dkay64/HOPEDeCal/HeliCALFiles/DFM analysis report_JLCDFM_Drill Files.pdf

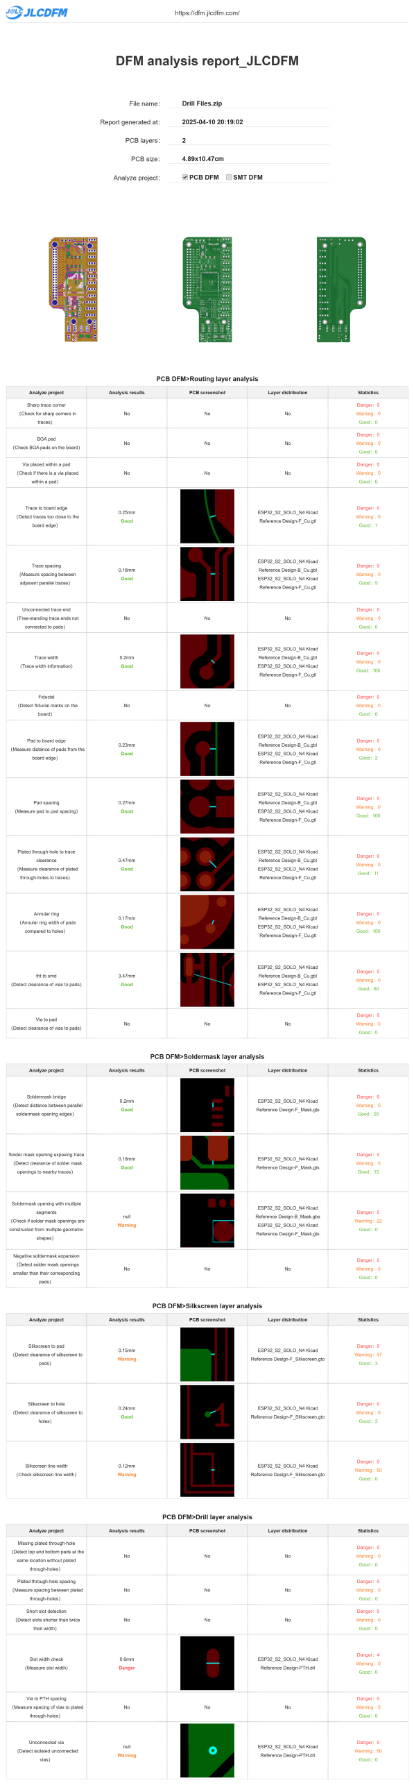
[picture p1: page 1]
