dkay64/HOPEDeCal/HeliCALFiles/HOPE HeliCAL Final Project BOM.xlsx

Sheet: BOM Template
Instructions
Fill in the cells with the YELLOW highlight. Do not edit red cells. WE WILL ADJUST THE MULTIPLIER TO ACCOUNT FOR MULTIPLE BOARDS, YOU SHOULD NOT. Fill out the Digi-Key part # OR the Mouser Part #, DO NOT fill out both. Choose the cheapest distributor that has the part in stock. If the part is not in stock by the time we order parts, there is a risk that we will not purchase it. For any approved Amazon or Adafruit parts, leave Digi-key and Mouser Part# columns blank like the example. For approved Amazon parts, put the ASIN (under the Product Information Section) for Manufacturer Part # in the format "Amazon - ##########". For approved Adafruit parts, put the Product ID for Manufacturer Part # in the format "Adafruit - ####". |  |  |  |  |  |  |  |  |  | Total Price for Project
 |  |  |  |  |  |  |  |  |  | $34.53
Qty (for 1 board) | Manufacturer Part # | Digi-key Part#/SKU | Price/unit ($) | Purchase URL | Reference Designator | Description (include component value if applicable) | Datasheet Link | Multiple | Total Qty | Total Price/part ($)
12 | 08056D104KAT2A | 478-08056D104KAT2ACT-ND | $0.10 | https://www.digikey.com/en/products/detail/kyocera-avx/08056D104KAT2A/11568656 | C1, C3, C5, C6, C7, C9 | CAP CER 0.1UF 6.3V X5R 0805 | http://datasheets.kyocera-avx.com/cx5r.pdf | 1 | 12 | $1.20
2 | CL10A106KQ8NNNC | 1276-1038-1-ND | $0.08 | https://www.digikey.com/en/products/detail/samsung-electro-mechanics/CL10A106KQ8NNNC/3886696 | C2 | CAP CER 10UF 6.3V X5R 0603 | https://mm.digikey.com/Volume0/opasdata/d220001/medias/docus/609/CL10A106KQ8NNNC_Spec.pdf | 1 | 2 | $0.16
2 | C0805C105K9RACTU | 399-13161-1-ND | $0.13 | https://www.digikey.com/en/products/detail/kemet/C0805C105K9RACTU/2211772 | C4 | CAP CER 1UF 6.3V X7R 0805 | https://search.kemet.com/download/datasheet/C0805C105K9RAC7800 | 1 | 2 | $0.26
2 | CHV1206N500103JCT | 4713-CHV1206N500103JCT-ND | $0.50 | https://www.digikey.com/en/products/detail/cal-chip-electronics-inc/CHV1206N500103JCT/22155331 | C8 | 0.01 µF ±5% 500V Ceramic Capacitor C0G, NP0 1206 (3216 Metric) | https://88ce57.p3cdn1.secureserver.net/wp-content/uploads/2023/01/chv_series-1.pdf | 1 | 2 | $1.00
2 | SML-D12D8WT86C | SML-D12D8WT86CCT-ND | $0.24 | https://www.digikey.com/en/products/detail/rohm-semiconductor/SML-D12D8WT86C/9448211 | D1 | LED ORANGE CLEAR 1608 SMD | https://fscdn.rohm.com/en/products/databook/datasheet/opto/led/chip_mono/sml-d12d8wt86(c)-e.pdf | 1 | 2 | $0.48
3 | SL84-3G | 4878-SL84-3GCT-ND | $0.53 | https://www.digikey.com/en/products/detail/diotec-semiconductor/SL84-3G/22189950 | D2, D3 | DIODE SCHOTTKY 40V 8A DO214AB | https://diotec.com/request/datasheet/sl82-3g.pdf | 1 | 3 | $1.59
5 | B4B-XH-A | 455-B4B-XH-A-ND | $0.17 | https://www.digikey.com/en/products/detail/jst-sales-america-inc/B4B-XH-A/1651047 | J14, J15, J16, J19 | CONN HEADER VERT 4POS 2.5MM | https://www.jst-mfg.com/product/pdf/eng/eXH.pdf | 1 | 5 | $0.85
3 | B2B-XH-A | 455-B2B-XH-A-ND | $0.10 | https://www.digikey.com/en/products/detail/jst-sales-america-inc/B2B-XH-A/1651045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 | J4, J17 | CONN HEADER VERT 2POS 2.5MM | https://www.jst-mfg.com/product/pdf/eng/eXH.pdf | 1 | 3 | $0.30
1 | USB4125-GF-A | 2073-USB4125-GF-ACT-ND | $0.59 | https://www.digikey.com/en/products/detail/gct/USB4125-GF-A/13547388 | J5 | CONN RCPT TYPE C 6P SMD RA | https://mm.digikey.com/Volume0/opasdata/d220001/medias/docus/6501/USB4125%20Product%20Spec.pdf | 1 | 1 | $0.59
10 | B3B-XH-A | 455-2248-ND | $0.13 | https://www.digikey.com/en/products/detail/jst-sales-america-inc/B3B-XH-A/1651046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 | J6, J7, J8, J9, J10, J11, J12, J13, J18 | CONN HEADER VERT 3POS 2.5MM | https://www.jst-mfg.com/product/pdf/eng/eXH.pdf | 1 | 10 | $1.30
4 | RC0603FR-075K1L | 311-5.10KHRCT-ND | $0.10 | https://www.digikey.com/en/products/detail/yageo/RC0603FR-075K1L/727268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 | R1, R3 | RES 5.1K OHM 1% 1/10W 0603 | https://www.yageo.com/upload/media/product/products/datasheet/rchip/PYu-RC_Group_51_RoHS_L_12.pdf | 1 | 4 | $0.40
2 | RT0603BRD07500RL | 13-RT0603BRD07500RLCT-ND | $0.10 | https://www.digikey.com/en/products/detail/yageo/RT0603BRD07500RL/17019950 | R2 | RES 500 OHM 0.1% 1/10W 0603 | https://www.yageo.com/upload/media/product/app/datasheet/rchip/pyu-rt_1-to-0.01_rohs_l.pdf | 1 | 2 | $0.20
8 | RR1220P-103-D | RR12P10.0KDCT-ND | $0.10 | https://www.digikey.com/en/products/detail/susumu/RR1220P-103-D/432315 | R4, R5, R6, R8 | RES SMD 10K OHM 0.5% 1/10W 0805 | https://www.susumu.co.jp/common/pdf/n_catalog_partition05_en.pdf | 1 | 8 | $0.80
1 | CF-LD-1DC-AR2W | 563-1943-ND | $3.31 | https://www.digikey.com/en/products/detail/nidec-components-corporation/CF-LD-1DC-AR2W/6008982 | SW1 | Rocker Switch SPDT 0.4VA (AC/DC) 28 V Through Hole | https://www.nidec-copal-electronics.com/e/catalog/switch/cf-ld.pdf | 1 | 1 | $3.31
2 | FSM6JSMA | 450-1133-ND | $0.28 | https://www.digikey.com/en/products/detail/te-connectivity-alcoswitch-switches/FSM6JSMA/525822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 | SW2, SW3 | SWITCH TACTILE SPST-NO 0.05A 24V | https://www.te.com/commerce/DocumentDelivery/DDEController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 | 1 | 2 | $0.56
1 | LD1117S33TR | 497-1242-1-ND | $0.34 | https://www.digikey.com/en/products/detail/stmicroelectronics/LD1117S33TR/585766 | U1 | IC REG LINEAR 3.3V 800MA SOT-223 | https://www.st.com/content/ccc/resource/technical/document/datasheet/99/3b/7d/91/91/51/4b/be/CD00000544.pdf/files/CD00000544.pdf/jcr:content/translations/en.C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 | 1 | 1 | $0.34
1 | M20-6102045 | M20-6102045 | $5.47 | https://www.digikey.com/en/products/detail/harwin-inc/M20-6102045/3728184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 | U2 | 40 Connector Stackthrough, Unkeyed (PC/104) Through Hole Black PC/104 | https://cdn.harwin.com/pdfs/M20-610.pdf | 1 | 1 | $5.47
1 | ESP32-S2-SOLO-2-N4 | 1965-ESP32-S2-SOLO-2-N4CT-ND | $4.25 | https://www.digikey.com/en/products/detail/espressif-systems/ESP32-S2-SOLO-2-N4/16591892 | U3 | RF TXRX MOD WIFI PCB TRACE SMD | https://www.espressif.com/sites/default/files/documentation/esp32-s2-solo-2_esp32-s2-solo-2u_datasheet_en.pdf | 1 | 1 | $4.25
1 | MPU-6500 | 1428-1011-1-ND | $7.17 | https://www.digikey.com/en/products/detail/tdk-invensense/MPU-6500/4385412 | U4 | IMU ACCEL/GYRO 3-AXIS I2C 24QFN | https://invensense.tdk.com/wp-content/uploads/2020/06/PS-MPU-6500A-01-v1.3.pdf | 1 | 1 | $7.17
5 | 3220-10-0100-00 | 1175-1627-ND | $0.56 | https://www.digikey.com/en/products/detail/cnc-tech/3220-10-0100-00/3883661 | U6, U7, U8, U9 | Connector Header Through Hole 10 position 0.050" (1.27mm) | http://www.cnctech.us/pdfs/3220-XX-0100-00_.pdf | 1 | 5 | $2.80
2 | XHP-2 | 455-2266-ND | $0.10 | https://www.digikey.com/en/products/detail/jst-sales-america-inc/XHP-2/555485 |  | CONN RCPT HSG 2POS 2.50MM | https://www.jst-mfg.com/product/pdf/eng/eXH.pdf | 1 | 2 | $0.20
9 | XHP-3 | 455-2219-ND | $0.10 | https://www.digikey.com/en/products/detail/jst-sales-america-inc/XHP-3/1651017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 |  | CONN RCPT HSG 3POS 2.50MM | https://www.jst-mfg.com/product/pdf/eng/eXH.pdf | 1 | 9 | $0.90
4 | XHP-4 | 455-2267-ND | $0.10 | https://www.digikey.com/en/products/detail/jst-sales-america-inc/XHP-4/683353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 |  | CONN RCPT HSG 4POS 2.50MM | https://www.jst-mfg.com/product/pdf/eng/eXH.pdf | 1 | 4 | $0.40
 |  |  |  |  |  |  |  |  | 0 | 0
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
 |  |  |  |  |  |  |  |  | 0 | 0
 |  |  |  |  |  |  |  |  | 0 | 0
 |  |  |  |  |  |  |  |  | 0 | 0
 |  |  |  |  |  |  |  |  | 0 | 0
 |  |  |  |  |  |  |  |  | 0 | 0
 |  |  |  |  |  |  |  |  | 0 | 0
 |  |  |  |  |  |  |  |  | 0 | 0
 |  |  |  |  |  |  |  |  | 0 | 0
 |  |  |  |  |  |  |  |  | 0 | 0
 |  |  |  |  |  |  |  |  | 0 | 0
 |  |  |  |  |  |  |  |  | 0 | 0
 |  |  |  |  |  |  |  |  | 0 | 0
 |  |  |  |  |  |  |  |  | 0 | 0
 |  |  |  |  |  |  |  |  | 0 | 0
 |  |  |  |  |  |  |  |  | 0 | 0
 |  |  |  |  |  |  |  |  | 0 | 0
 |  |  |  |  |  |  |  |  | 0 | 0
 |  |  |  |  |  |  |  |  | 0 | 0
 |  |  |  |  |  |  |  |  | 0 | 0
 |  |  |  |  |  |  |  |  | 0 | 0
 |  |  |  |  |  |  |  |  | 0 | 0
 |  |  |  |  |  |  |  |  | 0 | 0
 |  |  |  |  |  |  |  |  | 0 | 0
 |  |  |  |  |  |  |  |  | 0 | 0
 |  |  |  |  |  |  |  |  | 0 | 0
 |  |  |  |  |  |  |  |  | 0 | 0
 |  |  |  |  |  |  |  |  | 0 | 0
 |  |  |  |  |  |  |  |  | 0 | 0
 |  |  |  |  |  |  |  |  | 0 | 0
 |  |  |  |  |  |  |  |  | 0 | 0
 |  |  |  |  |  |  |  |  | 0 | 0
 |  |  |  |  |  |  |  |  | 0 | 0
 |  |  |  |  |  |  |  |  | 0 | 0
 |  |  |  |  |  |  |  |  | 0 | 0

Sheet: Example BOM
Partner 1 Name: John James | Partner 1 Email: realemail@berkeley.edu | Partner 2 Name: Erin Edison | Partner 2 Email: fakeemail@berkeley.edu | Partner 3 Name: Jim Mulligan | Partner 3 Email: superemail@berkeley.edu
Instructions
Fill in the cells with the YELLOW highlight. Do not edit red cells. WE WILL ADJUST THE MULTIPLIER TO ACCOUNT FOR MULTIPLE BOARDS, YOU SHOULD NOT. Fill out the Digi-Key part # OR the Mouser Part #, DO NOT fill out both. Choose the cheapest distributor that has the part in stock. If the part is not in stock by the time we order parts, there is a risk that we will not purchase it. For any approved Amazon or Adafruit parts, leave Digi-key and Mouser Part# columns blank like the example. For approved Amazon parts, put the ASIN (under the Product Information Section) for Manufacturer Part # in the format "Amazon - ##########". For approved Adafruit parts, put the Product ID for Manufacturer Part # in the format "Adafruit - ####" |  |  |  |  |  |  |  |  |  |  | Total Price for Project
 |  |  |  |  |  |  |  |  |  |  | $102.44
Qty (for 1 board) | Manufacturer Part # | Digi-key Part#/SKU | Mouser Part#/SKU | Price/unit ($) | Purchase URL | Reference Designator | Description (include component value if applicable) | Datasheet Link | Multiple | Total Qty | Total Price/part ($)
1 | ESP32-S2-SOLO-N4 | 1965-ESP32-S2-SOLO-N4CT-ND |  | $2.32 | ESP32-S2-SOLO-N4 Espressif Systems | RF/IF and RFID | DigiKey (https://www.digikey.com/en/products/detail/espressif-systems/esp32-s2-solo-n4/15222511) | U1 | WiFi 802.11b/g/n Transceiver Module 2.4GHz PCB Trace + IPEX Surface Mount | https://www.espressif.com/sites/default/files/documentation/esp32-s2-solo_esp32-s2-solo-u_datasheet_en.pdf | 2 | 2 | $4.64
1 | COM-18085 | 1568-COM-18085CT-ND |  | $9.75 | COM-18085 SparkFun Electronics | RF/IF and RFID | DigiKey (https://www.digikey.com/en/products/detail/sparkfun-electronics/COM-18085/16344552) | U2 | General ISM < 1GHz LoRa Transceiver Module 137MHz ~ 1.02GHz Antenna Not Included Surface Mount | https://cdn.sparkfun.com/assets/1/5/d/6/6/RFM95CW_Specification_EN_V1.0.pdf | 2 | 2 | $19.50
1 | PAM8302AASCR |  | 621-PAM8302AASCR | $0.44 | PAM8302AASCR Diodes Incorporated | Mouser (https://www.mouser.com/ProductDetail/Diodes-Incorporated/PAM8302AASCR?qs=pYVYkI7xuRXTVZEQSGcDyg%3D%3D) | U3 | Amplifier IC 1-Channel (Mono) Class D 8-MSOP | https://www.diodes.com/assets/Datasheets/PAM8302A.pdf https://www.diodes.com/assets/Evaluation-Boards/PAM8302A-User-Guide.pdf https://support.envistiamall.com/wp-content/uploads/2021/05/PAM8302A-module-schematic-Cropped.jpg | 2 | 2 | $0.88
1 | AS04004CO-2-R | 668-AS04004CO-2-R-ND |  | $2.67 | AS04004CO-2-R PUI Audio, Inc. | Audio Products | DigiKey (https://www.digikey.com/en/products/detail/pui-audio-inc/AS04004CO-2-R/11618422) | LS1 | SPEAKER 1.5W 4 OHM 550 HZ 84DB | http://puiaudio.com/pdf/AS04004CO-2-R.PDF | 2 | 2 | $5.34
1 | ANT-916-PW-RA | ANT-916-PW-RA-ND |  | $4.17 | ANT-916-PW-RA Linx Technologies Inc. | RF/IF and RFID | DigiKey (https://www.digikey.com/en/products/detail/linx-technologies-inc/ANT-916-PW-RA/340124) | AE1 | 915MHz ISM, LoRa, Sensor Networks, SigFox Whip, Tilt RF Antenna 816MHz ~ 1.095GHz 0dBi Screw-Mount Panel Mount | https://linxtechnologies.com/wp/wp-content/uploads/ant-916-pw-ra.pdf | 2 | 2 | $8.34
1 | MFS201N-9-Z | 563-1565-ND |  | $0.43 | 1825232-1 TE Connectivity ALCOSWITCH Switches | Switches | DigiKey (https://www.digikey.com/en/products/detail/te-connectivity-alcoswitch-switches/1825232-1/4021554) | S1 | Slide Switch SPDT Through Hole | https://www.te.com/commerce/DocumentDelivery/DDEController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 | 2 | 2 | $0.86
1 | GF-123-0000 | CWI332-ND |  | $1.06 | GF-123-0000 CW Industries | Switches | DigiKey (https://www.digikey.com/en/products/detail/cw-industries/GF-123-0000/4089767) | S2 | Slide Switch SPST Panel Mount | http://switches-connectors-custom.cwind.com/Asset/GF-123-Dimension-DRAWING.pdf | 2 | 2 | $2.12
3 | RMCF0603FT10K0 | RMCF0603FT10K0CT-ND |  | $0.10 | RMCF0603FT10K0 Stackpole Electronics Inc | Resistors | DigiKey (https://www.digikey.com/en/products/detail/stackpole-electronics-inc/RMCF0603FT10K0/1761235) | R1, R5, R6 | 10 kOhms ±1% 0.1W, 1/10W Chip Resistor 0603 (1608 Metric) Automotive AEC-Q200 Thick Film | https://www.seielect.com/catalog/sei-rmcf_rmcp.pdf | 2 | 6 | $0.60
1 | RMCF0402ZT0R00 | RMCF0402ZT0R00CT-ND |  | $0.10 | RMCF0402ZT0R00 Stackpole Electronics Inc | Resistors | DigiKey (https://www.digikey.com/en/products/detail/stackpole-electronics-inc/RMCF0402ZT0R00/1756905) | R2 | 0 Ohms Jumper 0.063W, 1/16W Chip Resistor 0402 (1005 Metric) Automotive AEC-Q200 Thick Film | https://www.seielect.com/catalog/sei-rmcf_rmcp.pdf | 2 | 2 | $0.20
5 | 06035C104KAT2A | 478-5052-1-ND |  | $0.10 | 06035C104KAT2A KYOCERA AVX | Capacitors | DigiKey (https://www.digikey.com/en/products/detail/kyocera-avx/06035C104KAT2A/1600046) | C1, C12, C13, C15, C21 | 0.1 µF ±10% 50V Ceramic Capacitor X7R 0603 (1608 Metric) | https://datasheets.kyocera-avx.com/X7RDielectric.pdf | 2 | 10 | $1.00
1 | CC0402MRX5R6BB225 | 311-1733-1-ND |  | $0.10 | CC0402MRX5R6BB225 YAGEO | Capacitors | DigiKey (https://www.digikey.com/en/products/detail/yageo/CC0402MRX5R6BB225/5195142) | C2 | 2.2 µF ±20% 10V Ceramic Capacitor X5R 0402 (1005 Metric) | https://www.yageo.com/upload/media/product/productsearch/datasheet/mlcc/UPY-GPHC_X5R_4V-to-50V_26.pdf | 2 | 2 | $0.20
4 | C0402C220J3GACAUTO | 399-C0402C220J3GACAUTOCT-ND |  | $0.10 | C0402C220J3GACAUTO KEMET | Capacitors | DigiKey (https://www.digikey.com/en/products/detail/kemet/C0402C220J3GACAUTO/10642905) | C3, C4, C5, C6 | 22 pF ±5% 25V Ceramic Capacitor C0G, NP0 0402 (1005 Metric) | https://api.kemet.com/component-edge/download/datasheet/C0402C220J3GACAUTO.pdf | 2 | 8 | $0.80
1 | ATFC-0402HQ-1N8B-T | 535-12335-1-ND |  | $0.10 | ATFC-0402HQ-1N8B-T Abracon LLC | Inductors, Coils, Chokes | DigiKey (https://www.digikey.com/en/products/detail/abracon-llc/ATFC-0402HQ-1N8B-T/4215221) | L1 | 1.8 nH Unshielded Thin Film Inductor 650 mA 140mOhm Max 0402 (1005 Metric) | https://abracon.com/Magnetics/inductors/ATFC-0402HQ.pdf | 2 | 2 | $0.20
2 | 7447840147G | 732-7447840147GCT-ND |  | $0.10 | 7447840147G Würth Elektronik | Inductors, Coils, Chokes | DigiKey (https://www.digikey.com/en/products/detail/w%C3%BCrth-elektronik/7447840147G/14669548) | L2, L3 | 47 nH Unshielded Multilayer Inductor 200 mA 1.15Ohm Max 0402 (1005 Metric) | https://www.we-online.com/catalog/datasheet/7447840147G.pdf | 2 | 4 | $0.40
1 | LM2575D2T-3.3R4G |  | 863-LM2575D2T-3.3R4G | $2.38 | LM2575D2T-3.3R4G onsemi | Mouser (https://www.mouser.com/ProductDetail/onsemi/LM2575D2T-3.3R4G?qs=2OtswVQKCOFhf1pTPfoNzA%3D%3D) | U5 | Buck Switching Regulator IC Positive Fixed 3.3V 1 Output 1A TO-263-6, D²Pak (5 Leads + Tab), TO-263BA | https://www.onsemi.com/pdf/datasheet/lm2575-d.pdf | 2 | 2 | $4.76
1 | UUD1C270MCL1GS | 493-2257-1-ND |  | $0.48 | UUD1C270MCL1GS Nichicon | Capacitors | DigiKey (https://www.digikey.com/en/products/detail/nichicon/UUD1C270MCL1GS/589998) | C7 | 27 µF 16 V Aluminum Electrolytic Capacitors Radial, Can - SMD - 2000 Hrs @ 105°C | https://www.nichicon.co.jp/english/products/pdfs/e-uud.pdf | 2 | 2 | $0.96
1 | 865080142007 | 732-8472-1-ND |  | $0.20 | 865080142007 Würth Elektronik | Capacitors | DigiKey (https://www.digikey.com/en/products/detail/w%C3%BCrth-elektronik/865080142007/5728067) | C8 | 100 µF 6.3 V Aluminum Electrolytic Capacitors Radial, Can - SMD - 2000 Hrs @ 105°C | https://www.we-online.com/katalog/datasheet/865080142007.pdf | 2 | 2 | $0.40
1 | 1N5817 | 497-4547-1-ND |  | $0.42 | 1N5817 STMicroelectronics | Discrete Semiconductor Products | DigiKey (https://www.digikey.com/en/products/detail/stmicroelectronics/1N5817/770971) | D1 | Diode Schottky 20 V 1A Through Hole DO-41 | https://www.st.com/content/ccc/resource/technical/document/datasheet/26/db/14/60/52/47/47/5b/CD00001625.pdf/files/CD00001625.pdf/jcr:content/translations/en.C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 | 2 | 2 | $0.84
1 | AIUR-09-151K | AIUR-09-151K-ND |  | $0.83 | AIUR-09-151K Abracon LLC | Inductors, Coils, Chokes | DigiKey (https://www.digikey.com/en/products/detail/abracon-llc/AIUR-09-151K/2343697) | L4 | 150 µH Unshielded Wirewound Inductor 1 A 510mOhm Max Radial, Vertical Cylinder | https://abracon.com/Magnetics/radial/AIUR-09_Datasheet1.pdf | 2 | 2 | $1.66
5 | CL10B105MO8NNWC | 1276-6524-1-ND |  | $0.10 | CL10B105MO8NNWC Samsung Electro-Mechanics | Capacitors | DigiKey (https://www.digikey.com/en/products/detail/samsung-electro-mechanics/CL10B105MO8NNWC/5961008) | C9, C10, C11, C14, C16 | 1 µF ±20% 16V Ceramic Capacitor X7R 0603 (1608 Metric) | https://media.digikey.com/pdf/Data%20Sheets/Samsung%20PDFs/CL10B105MO8NNWC.pdf | 2 | 10 | $1.00
1 | 0ZRP0065FF1E | 507-2404-ND |  | $0.40 | 0ZRP0065FF1E Bel Fuse Inc. | Circuit Protection | DigiKey (https://www.digikey.com/en/products/detail/bel-fuse-inc/0ZRP0065FF1E/9468253) | F1 | Polymeric PTC Resettable Fuse 60V 650 mA Ih Through Hole Radial, Disc | https://media.digikey.com/pdf/Data%20Sheets/Bel%20Fuse%20PDFs/0ZRP_Series.pdf | 2 | 2 | $0.80
2 | GPTS203211B | CW181-ND |  | $1.71 | GPTS203211B CW Industries | Switches | DigiKey (https://www.digikey.com/en/products/detail/cw-industries/GPTS203211B/3190590) | S3, S4 | Pushbutton Switch SPST Standard Through Hole | http://switches-connectors-custom.cwind.com/Asset/GPTS203211BR2.pdf | 2 | 4 | $6.84
2 | 860020372001 | 732-8788-1-ND |  | $0.10 | 860020372001 Würth Elektronik | Capacitors | DigiKey (https://www.digikey.com/en/products/detail/w%C3%BCrth-elektronik/860020372001/5728733) | C17, C20 | 10 µF 16 V Aluminum Electrolytic Capacitors Radial, Can - 2000 Hrs @ 105°C | https://www.we-online.com/katalog/datasheet/860020372001.pdf | 2 | 4 | $0.40
2 | 0603B221K500CT | 1292-1407-1-ND |  | $0.10 | 0603B221K500CT Walsin Technology Corporation | Capacitors | DigiKey (https://www.digikey.com/en/products/detail/walsin-technology-corporation/0603B221K500CT/9354904) | C18, C19 | 220 pF ±10% 50V Ceramic Capacitor X7R 0603 (1608 Metric) | http://www.passivecomponent.com/wp-content/uploads/datasheet/WTC_MLCC_General_Purpose.pdf | 2 | 4 | $0.40
2 | MAF1608GAD601CT000 | 445-181518-1-ND |  | $0.21 | MAF1608GAD601CT000 TDK Corporation | Filters | DigiKey (https://www.digikey.com/en/products/detail/tdk-corporation/MAF1608GAD601CT000/9951529) | FB1, FB2 | 120 Ohms @ 100 MHz 1 Power Line Ferrite Bead 0603 (1608 Metric) 1A 150mOhm | https://product.tdk.com/en/system/files | 2 | 4 | $0.84
2 | RMCF0603FT100R | RMCF0603FT100RCT-ND |  | $0.10 | RMCF0603FT100R Stackpole Electronics Inc | Resistors | DigiKey (https://www.digikey.com/en/products/detail/stackpole-electronics-inc/RMCF0603FT100R/1761113) | R3, R4 | 100 Ohms ±1% 0.1W, 1/10W Chip Resistor 0603 (1608 Metric) Automotive AEC-Q200 Thick Film | https://www.seielect.com/catalog/sei-rmcf_rmcp.pdf | 2 | 4 | $0.40
1 | TC33X-1-103E | TC33X-1-103ECT-ND |  | $0.28 | TC33X-1-103E Bourns Inc. | Potentiometers, Variable Resistors | DigiKey (https://www.digikey.com/en/products/detail/bourns-inc/TC33X-1-103E/2566867) | RV1 | 10 kOhms 0.1W, 1/10W J Lead Surface Mount Trimmer Potentiometer Cermet 1.0 Turn Top Adjustment | https://www.bourns.com/docs/Product-Datasheets/TC33.pdf | 2 | 2 | $0.56
1 | 10118194-0001LF | 609-4618-1-ND |  | $0.48 | 10118194-0001LF Amphenol ICC (FCI) | Connectors, Interconnects | DigiKey (https://www.digikey.com/en/products/detail/amphenol-icc-fci/10118194-0001LF/2785389) | J1 | USB - micro B USB 2.0 Receptacle Connector 5 Position Surface Mount, Right Angle; Through Hole | https://www.amphenol-icc.com/media/wysiwyg/files/drawing/10118194.pdf | 2 | 2 | $0.96
2 | B1911NG--20D000214U1930 | 3147-B1911NG--20D000214U1930CT-ND |  | $0.10 | B1911NG--20D000214U1930 Harvatek Corporation | Optoelectronics | DigiKey (https://www.digikey.com/en/products/detail/harvatek-corporation/B1911NG-20D000214U1930/15519989) | D2, D3 | LED GREEN CLEAR 1608 SMD | https://media.digikey.com/pdf/Data%20Sheets/Harvatek%20PDFs/B1911NG--20D000214U1930.pdf | 2 | 4 | $0.40
1 | CRGCQ0603F120R | A129677CT-ND |  | $0.10 | CRGCQ0603F120R TE Connectivity Passive Product | Resistors | DigiKey (https://www.digikey.com/en/products/detail/te-connectivity-passive-product/CRGCQ0603F120R/8576279) | R7 | 120 Ohms ±1% 0.1W, 1/10W Chip Resistor 0603 (1608 Metric) Automotive AEC-Q200, Moisture Resistant Thick Film | https://www.te.com/commerce/DocumentDelivery/DDEController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 | 2 | 2 | $0.20
1 | Amazon - B09PN8S8L1 |  |  | $27.99 | Amazon.com: MUSIBEAUTY Universal 18650 Charger Battery with Rechargeable Battery 3.7V 3400mAh (4 Pack) for Doorbells, Flashlights, Headlamps, Cameras, Toys, and Remote Controls : Electronics (https://www.amazon.com/MUSIBEAUTY-Universal-Rechargeable-Doorbells-Flashlights/dp/B09PN8S8L1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) | B1, B2 | Universal 18650 Charger Battery with Rechargeable Battery 3.7V 3400mAh (4 Pack) |  | 1 | 1 | $27.99
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
 |  |  |  |  |  |  |  |  |  | 0 | 0
 |  |  |  |  |  |  |  |  |  | 0 | 0
 |  |  |  |  |  |  |  |  |  | 0 | 0
 |  |  |  |  |  |  |  |  |  | 0 | 0
 |  |  |  |  |  |  |  |  |  | 0 | 0
 |  |  |  |  |  |  |  |  |  | 0 | 0
 |  |  |  |  |  |  |  |  |  | 0 | 0
 |  |  |  |  |  |  |  |  |  | 0 | 0
 |  |  |  |  |  |  |  |  |  | 0 | 0
 |  |  |  |  |  |  |  |  |  | 0 | 0
 |  |  |  |  |  |  |  |  |  | 0 | 0
 |  |  |  |  |  |  |  |  |  | 0 | 0
 |  |  |  |  |  |  |  |  |  | 0 | 0
 |  |  |  |  |  |  |  |  |  | 0 | 0
 |  |  |  |  |  |  |  |  |  | 0 | 0
 |  |  |  |  |  |  |  |  |  | 0 | 0
