dkay64/HOPEDeCal/HeliCALFiles/Project/ESP32_S2_SOLO_N4 Kicad Reference Design.pdf

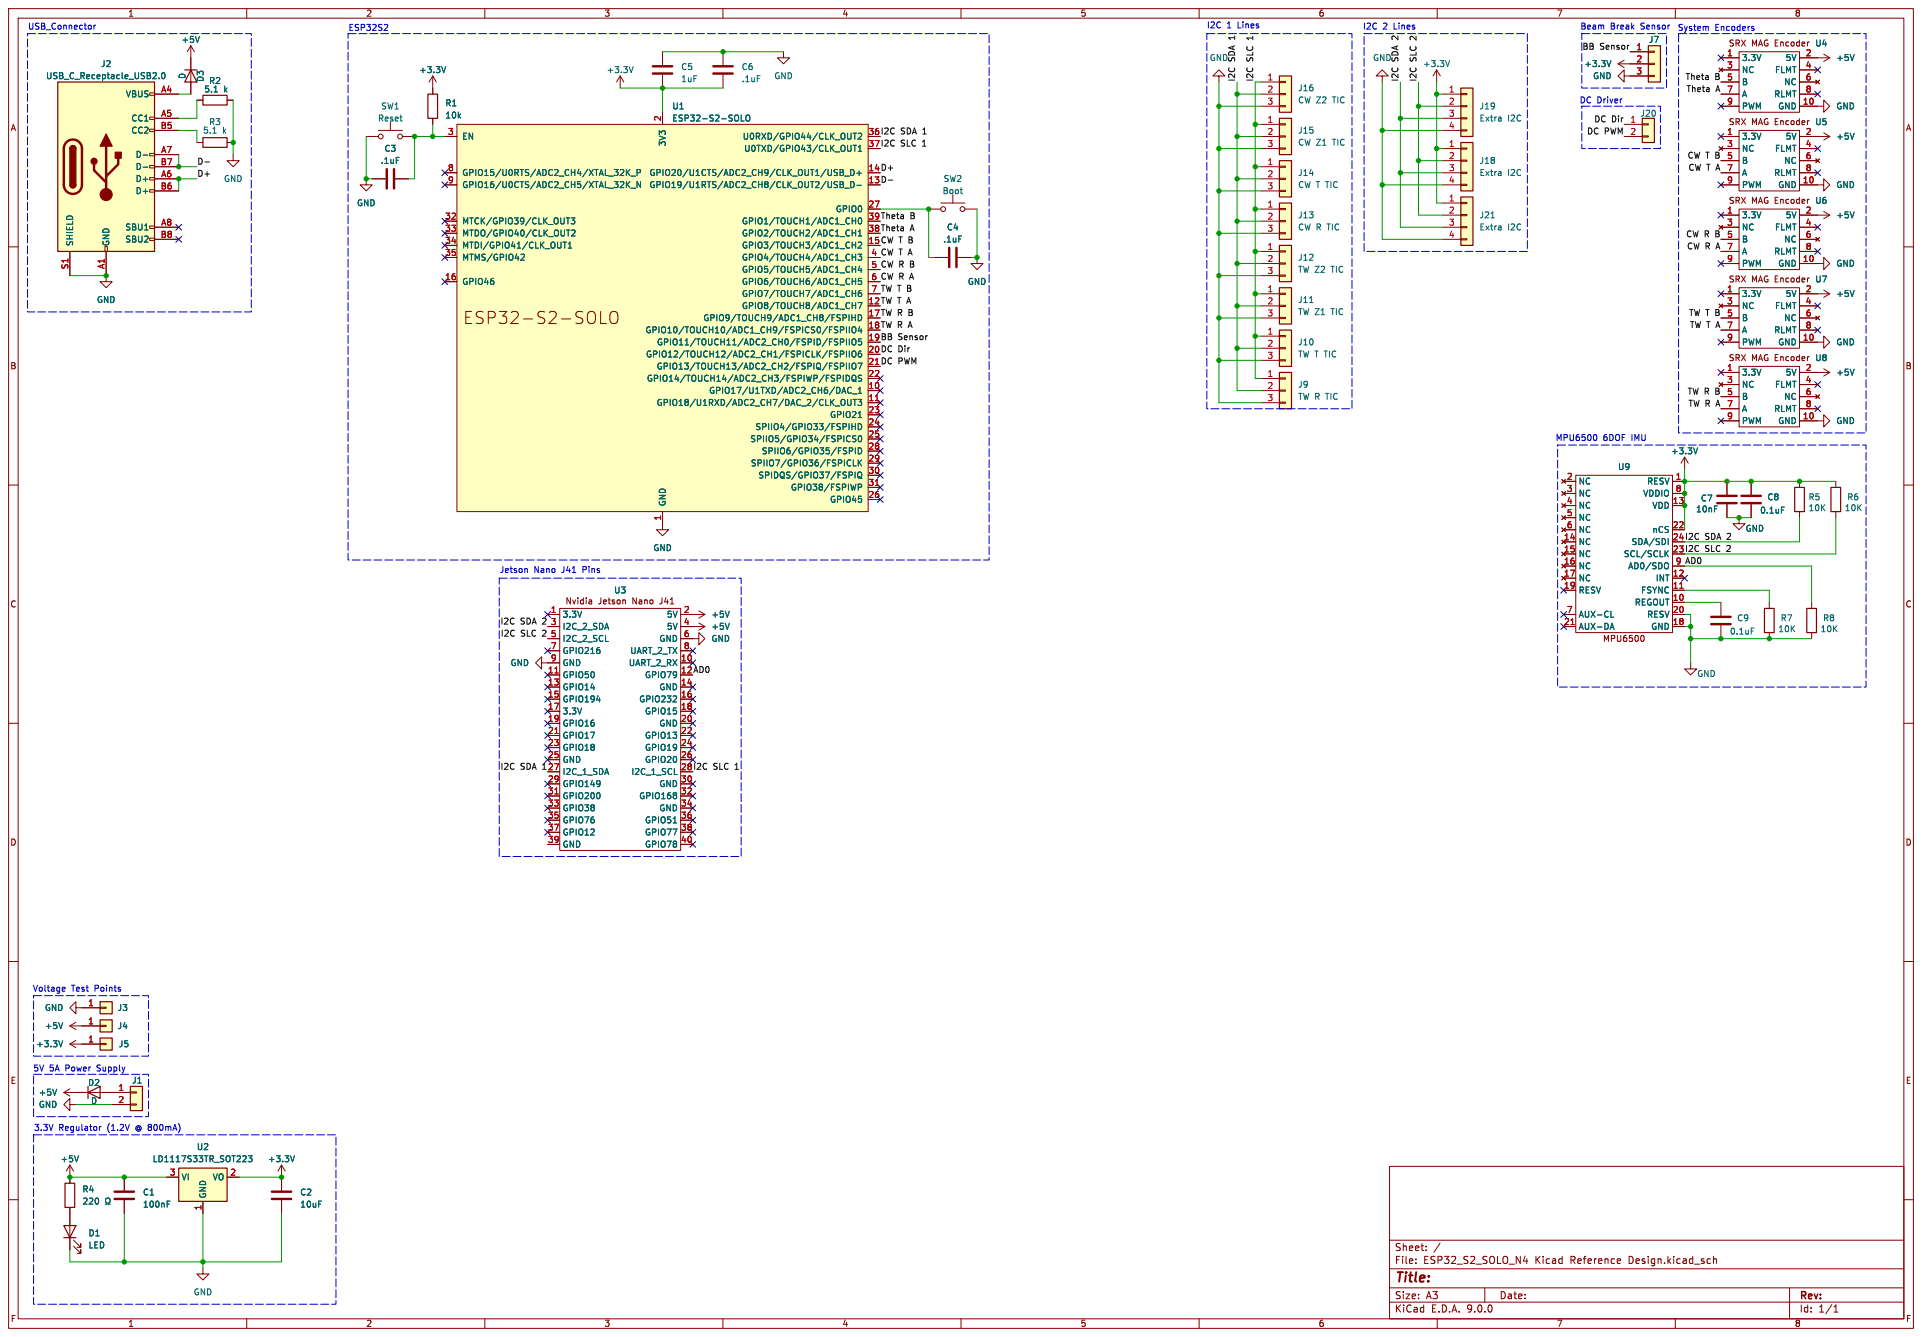
[picture p2: page 1]

DC Dir DC PWM

SRX MAG Encoder 3.3V 1 NC 3 B 5 A 7 PWM 9
3.3V 1 NC 3 B 5 A 7 PWM 9

5V 2 FLMT 4 NC 6 RLMT 8 GND
