dkay64/HOPEDeCal/HeliCALFiles/Project/ESP32_S2_SOLO_N4 Kicad Reference Design.kicad_pcb

## KiCad design HeliCALFiles/Project/ESP32_S2_SOLO_N4 Kicad Reference Design.kicad_pcb (2025-05-08)

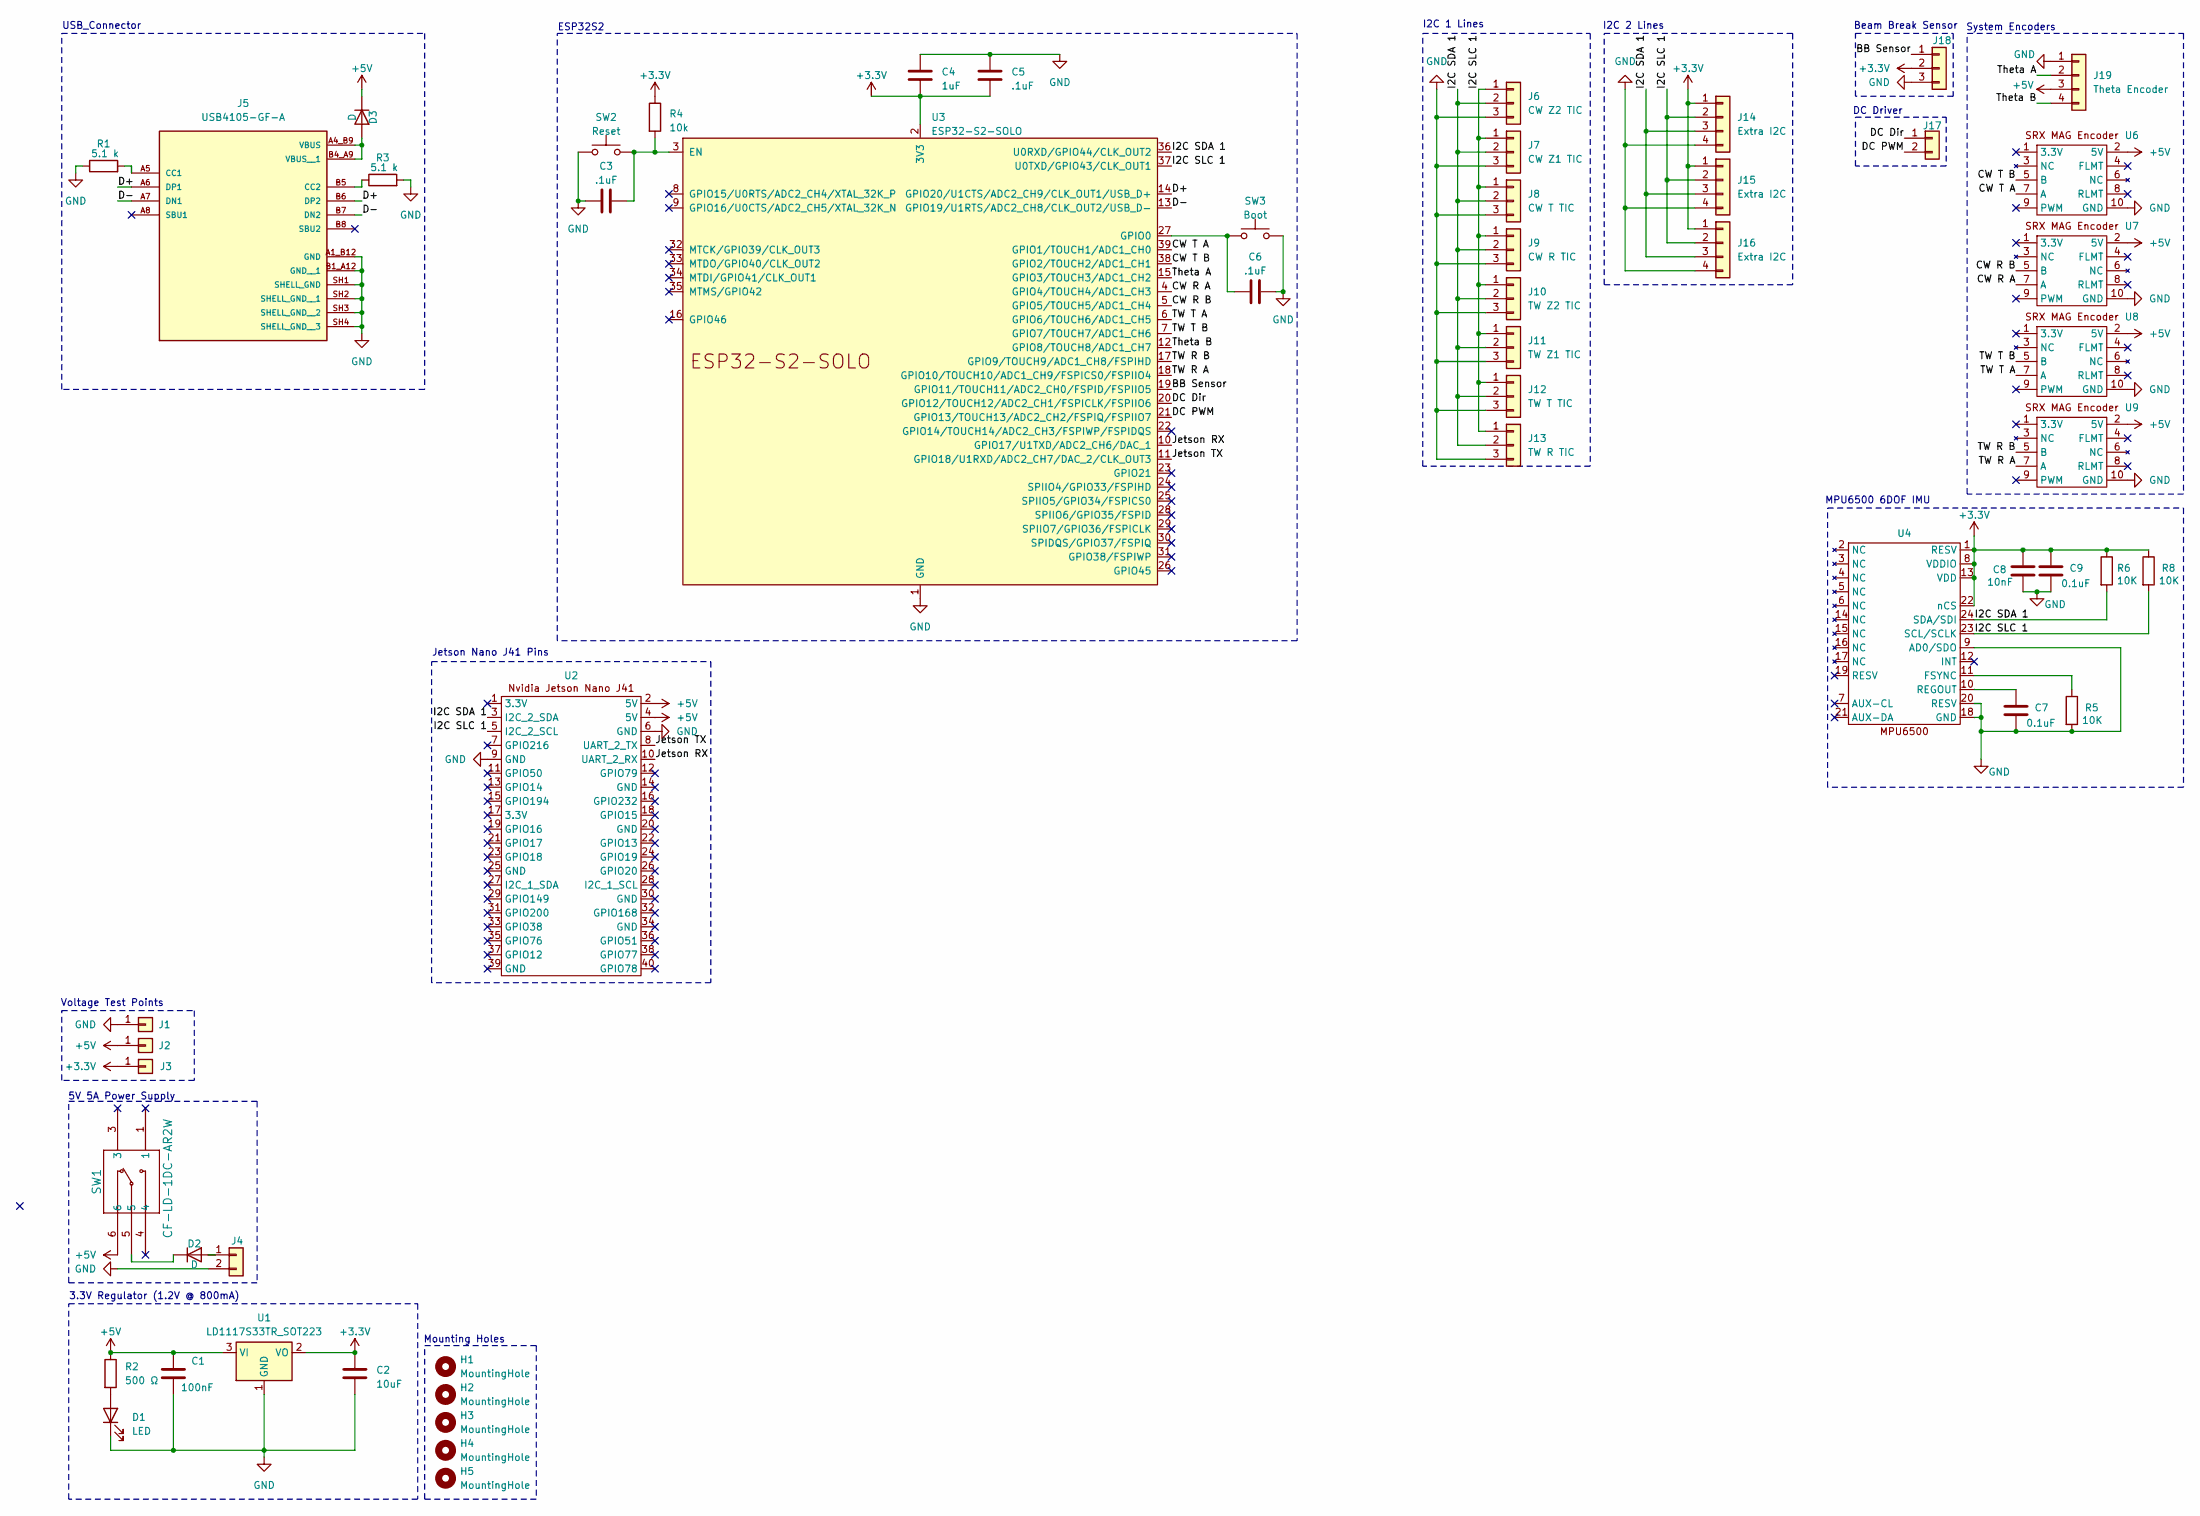
[picture p3: schematic ESP32_S2_SOLO_N4 Kicad Reference Design.kicad_sch]

Parts:
C1: 100nF; C_0805_2012Metric
C2: 10uF; C_0603_1608Metric
C3, C5, C6: .1uF; C_0805_2012Metric
C4: 1uF; C_0805_2012Metric
C7, C9: 0.1uF; C_0805_2012Metric
C8: 10nF; C_1206_3216Metric
D1: LED; LED_0603_1608Metric
D2, D3: D; D_SMB-SMC_Universal_Handsoldering
H1, H2: MountingHole; MountingHole_2.7mm_Pad_Via
H3, H4, H5: MountingHole; MountingHole_2.5mm_Pad_Via
J1, J2, J3: Conn_01x01; PinSocket_1x01_P2.54mm_Vertical
J4, J17: Conn_01x02; JST_EH_B2B-EH-A_1x02_P2.50mm_Vertical
J5: USB4105-GF-A; GCT_USB4105-GF-A; PARTREV B4
J6: CW Z2 TIC; JST_EH_B3B-EH-A_1x03_P2.50mm_Vertical
J7: CW Z1 TIC; JST_EH_B3B-EH-A_1x03_P2.50mm_Vertical
J8: CW T TIC; JST_EH_B3B-EH-A_1x03_P2.50mm_Vertical
J9: CW R TIC; JST_EH_B3B-EH-A_1x03_P2.50mm_Vertical
J10: TW Z2 TIC; JST_EH_B3B-EH-A_1x03_P2.50mm_Vertical
J11: TW Z1 TIC; JST_EH_B3B-EH-A_1x03_P2.50mm_Vertical
J12: TW T TIC; JST_EH_B3B-EH-A_1x03_P2.50mm_Vertical
J13: TW R TIC; JST_EH_B3B-EH-A_1x03_P2.50mm_Vertical
J14, J15, J16: Extra I2C; JST_EH_B4B-EH-A_1x04_P2.50mm_Vertical
J18: Conn_01x03; JST_EH_B3B-EH-A_1x03_P2.50mm_Vertical
J19: Theta Encoder; JST_EH_B4B-EH-A_1x04_P2.50mm_Vertical
R1, R3: 5.1 k; R_0603_1608Metric
R2: 500 Ω; R_0603_1608Metric
R4: 10k; R_0805_2012Metric
R5, R6, R8: 10K; R_0805_2012Metric
SW1: CF-LD-1DC-AR2W; CF-LD-1DC-AR2W_NDC
SW2: Reset; TE_4-1437565-9
SW3: Boot; TE_4-1437565-9
U1: LD1117S33TR_SOT223; SOT-223-3_TabPin2
U2: PinHeader_2x20_P2.54mm_Vertical
U3: ESP32-S2-SOLO
U4: InvenSense_QFN-24_3x3mm_P0.4mm
U6, U7, U8, U9: PinHeader_2x05_P1.27mm_Vertical

Connections:
+3.3V: C2.1, C4.2, C5.2, C8.1, C9.1, J3.1, J14.1, J15.1, J16.1, J18.2, R4.1, R6.1, R8.1, U1.2 (VO), U3.2 (3V3), U4.1 (RESV), U4.8 (VDDIO), U4.13 (VDD), U4.22 (nCS)
+5V: C1.1, D3.1 (K), J2.1, J19.3, R2.1, SW1.6, U1.3 (VI), U2.2 (5V), U2.4 (5V), U6.2 (5V), U7.2 (5V), U8.2 (5V), U9.2 (5V)
/BB Sensor: J18.1, U3.19 (GPIO11/TOUCH11/ADC2_CH0/FSPID/FSPIIO5)
/CW R A: U3.4 (GPIO4/TOUCH4/ADC1_CH3), U7.7 (A)
/CW R B: U3.5 (GPIO5/TOUCH5/ADC1_CH4), U7.5 (B)
/CW T A: U3.39 (GPIO1/TOUCH1/ADC1_CH0), U6.7 (A)
/CW T B: U3.38 (GPIO2/TOUCH2/ADC1_CH1), U6.5 (B)
/D+: J5.A6 (DP1), J5.B6 (DP2), U3.14 (GPIO20/U1CTS/ADC2_CH9/CLK_OUT1/USB_D+)
/D-: J5.A7 (DN1), J5.B7 (DN2), U3.13 (GPIO19/U1RTS/ADC2_CH8/CLK_OUT2/USB_D-)
/DC Dir: J17.1, U3.20 (GPIO12/TOUCH12/ADC2_CH1/FSPICLK/FSPIIO6)
/DC PWM: J17.2, U3.21 (GPIO13/TOUCH13/ADC2_CH2/FSPIQ/FSPIIO7)
/I2C SDA 1: J6.2, J7.2, J8.2, J9.2, J10.2, J11.2, J12.2, J13.2, J14.3, J15.3, J16.3, R6.2, U2.3 (I2C_2_SDA), U3.36 (U0RXD/GPIO44/CLK_OUT2), U4.24 (SDA/SDI)
/I2C SLC 1: J6.1, J7.1, J8.1, J9.1, J10.1, J11.1, J12.1, J13.1, J14.2, J15.2, J16.2, R8.2, U2.5 (I2C_2_SCL), U3.37 (U0TXD/GPIO43/CLK_OUT1), U4.23 (SCL/SCLK)
/Jetson RX: U2.10 (UART_2_RX), U3.10 (GPIO17/U1TXD/ADC2_CH6/DAC_1)
/Jetson TX: U2.8 (UART_2_TX), U3.11 (GPIO18/U1RXD/ADC2_CH7/DAC_2/CLK_OUT3)
/TW R A: U3.18 (GPIO10/TOUCH10/ADC1_CH9/FSPICS0/FSPIIO4), U9.7 (A)
/TW R B: U3.17 (GPIO9/TOUCH9/ADC1_CH8/FSPIHD), U9.5 (B)
/TW T A: U3.6 (GPIO6/TOUCH6/ADC1_CH5), U8.7 (A)
/TW T B: U3.7 (GPIO7/TOUCH7/ADC1_CH6), U8.5 (B)
/Theta A: J19.2, U3.15 (GPIO3/TOUCH3/ADC1_CH2)
/Theta B: J19.4, U3.12 (GPIO8/TOUCH8/ADC1_CH7)
GND: C1.2, C2.2, C3.1, C4.1, C5.1, C6.2, C7.2, C8.2, C9.2, D1.1 (K), J1.1, J4.2, J5.A1_B12 (GND), J5.B1_A12 (GND__1), J5.SH1 (SHELL_GND), J5.SH2 (SHELL_GND__1), J5.SH3 (SHELL_GND__2), J5.SH4 (SHELL_GND__3), J6.3, J7.3, J8.3, J9.3, J10.3, J11.3, J12.3, J13.3, J14.4, J15.4, J16.4, J18.3, J19.1, R1.1, R3.2, R5.2, SW2.1, SW3.2, U1.1 (GND), U2.6 (GND), U2.9 (GND), U3.1 (GND), U3.40 (GND), U3.41 (GND), U4.9 (AD0/SDO), U4.18 (GND), U4.20 (RESV), U6.10 (GND), U7.10 (GND), U8.10 (GND), U9.10 (GND)
unnamed: D1.2 (A), R2.2
unnamed: D2.2 (A), J4.1
unnamed: D2.1 (K), SW1.5
unnamed: D3.2 (A), J5.A4_B9 (VBUS), J5.B4_A9 (VBUS__1)
unnamed: J5.A5 (CC1), R1.2
unnamed: J5.B5 (CC2), R3.1
unnamed: C3.2, R4.2, SW2.2, U3.3 (EN)
unnamed: C6.1, SW3.1, U3.27 (GPIO0)
unnamed: R5.1, U4.11 (FSYNC)
unnamed: C7.1, U4.10 (REGOUT)

Notes on the sheet:
Beam Break Sensor
DC Driver
I2C 1 Lines
MPU6500 6DOF IMU
5V 5A Power Supply
Jetson Nano J41 Pins
Voltage Test Points
Mounting Holes
System Encoders
USB_Connector
ESP32S2
3.3V Regulator (1.2V @ 800mA)
I2C 2 Lines

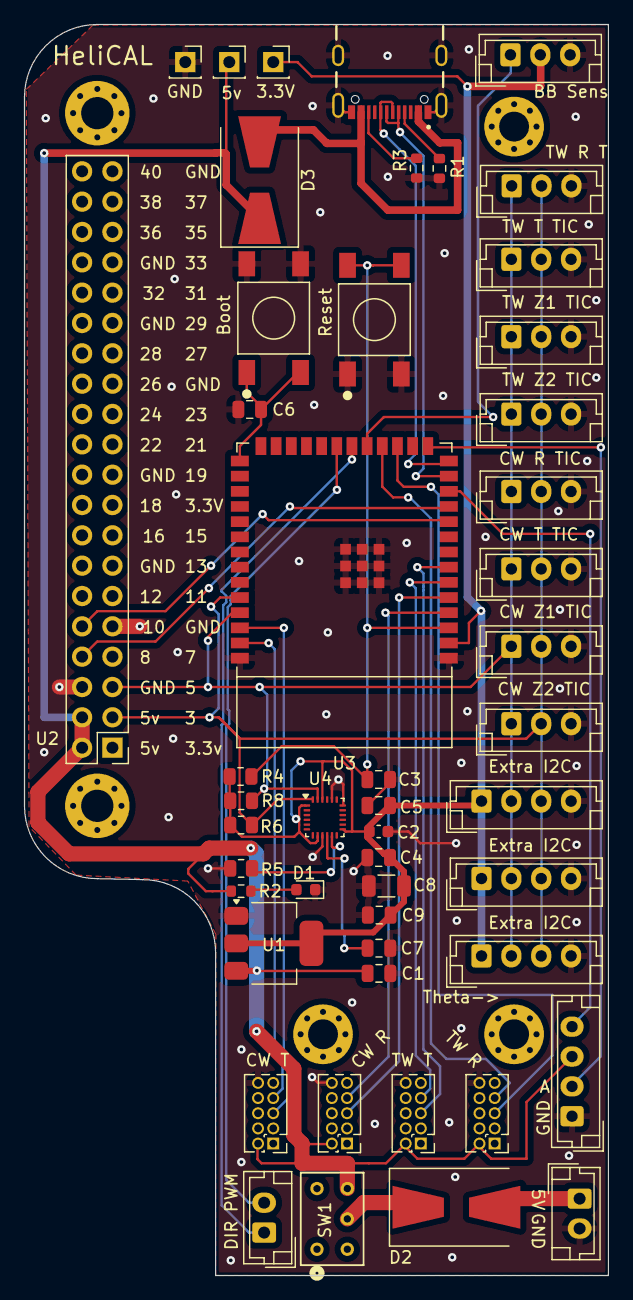
[picture p4: board ESP32_S2_SOLO_N4 Kicad Reference Design.kicad_pcb from above]

Board: 2 copper layers, 48.9 x 104.7 mm, 54 parts (0 on the bottom side), 32 nets.
