dkay64/HOPEDeCal/DKUSBCharger/DKUSBCharger.kicad_pcb

## KiCad design DKUSBCharger/DKUSBCharger.kicad_pcb (2025-03-09)

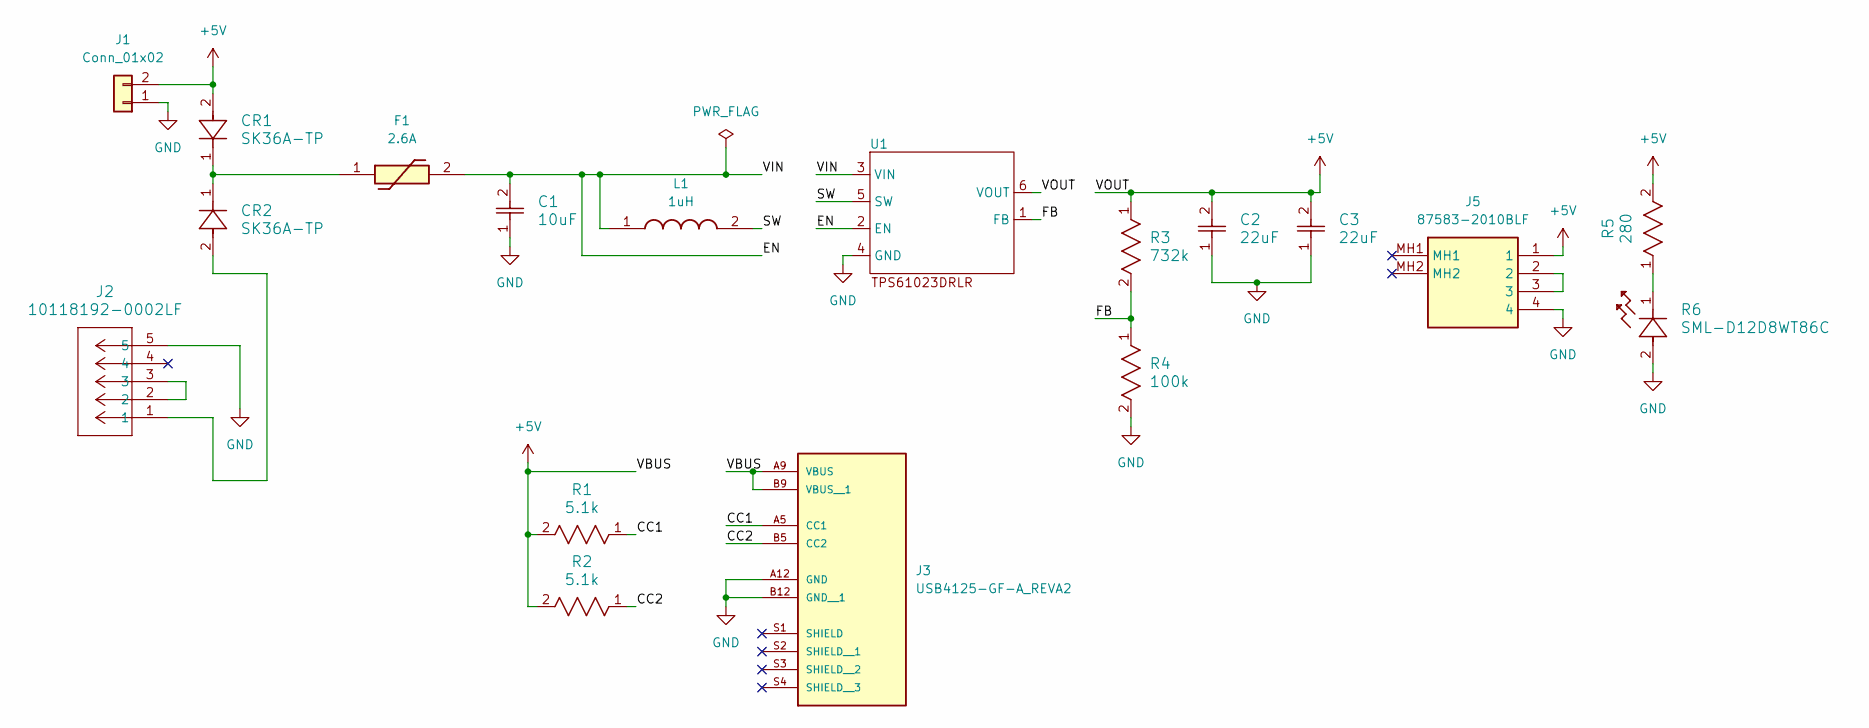
[picture p5: schematic DKUSBCharger.kicad_sch]

Parts:
C1: 10uF; CAP_CL10_SAM
C2, C3: 22uF; G-188_MUR
CR1, CR2: SK36A-TP; SMCDO-214AB_MCC
F1: 2.6A; FUSC4632X205N; Manufacturer_Part_Number SMD1812B260TF/12; Mouser Part Number 603-SMD1812B260TF/12
J1: Conn_01x02; PinHeader_1x02_P2.54mm_Vertical
J2: 10118192-0002LF; CONN_10118192-0002LF_AMP
J3: USB4125-GF-A_REVA2; GCT_USB4125-GF-A_REVA2; PARTREV Rev A2
J5: 87583-2010BLF; 875832010BLF; Manufacturer_Part_Number 87583-2010BLF
L1: 1uH; INDC2012X80N; Manufacturer_Part_Number LPWI201208S1R0T; Mouser Part Number 576-LPWI201208S1R0T
R1, R2: 5.1k; RC0603N_YAG
R3: 732k; RC0603N_PAN
R4: 100k; RC0603N_PAN_100k
R5: 280; RESC1608X50N
R6: SML-D12D8WT86C; LED_SMLD12_ROM
U1: DRL0006A

Connections:
+5V: C2.2, C3.2, CR1.2, J1.2, J3.A9 (VBUS), J3.B9 (VBUS__1), J5.1, R1.2, R2.2, R3.1, R5.2, U1.6 (VOUT)
/CC1: J3.A5 (CC1), R1.1
/CC2: J3.B5 (CC2), R2.1
/EN: C1.2, F1.2, L1.1, U1.2 (EN), U1.3 (VIN)
/FB: R3.2, R4.1, U1.1 (FB)
/SW: L1.2, U1.5 (SW)
GND: C1.1, C2.1, C3.1, J1.1, J2.5, J3.A12 (GND), J3.B12 (GND__1), J5.4, R4.2, R6.2, U1.4 (GND)
unnamed: CR1.1, CR2.1, F1.1
unnamed: CR2.2, J2.1
unnamed: J2.2, J2.3
unnamed: J5.2, J5.3
unnamed: R5.1, R6.1

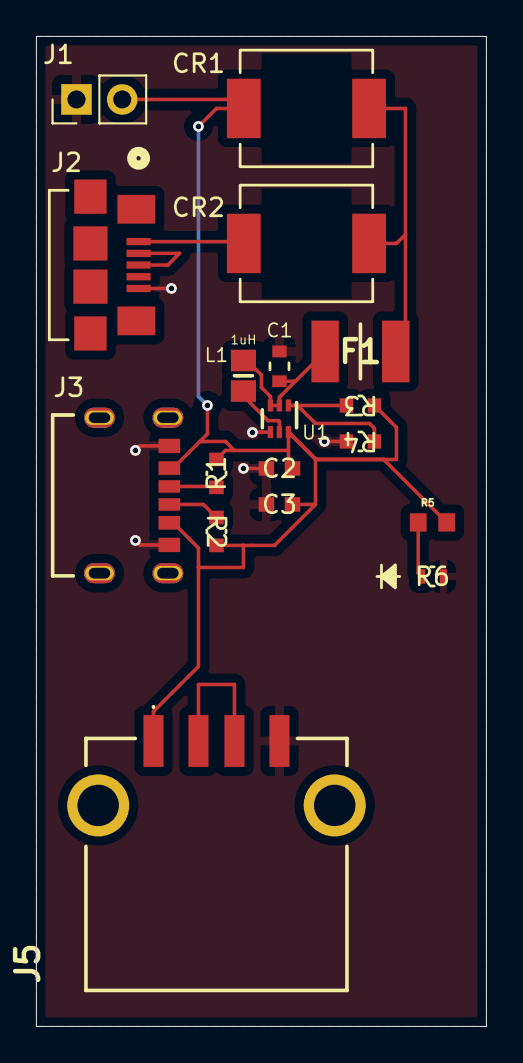
[picture p6: board DKUSBCharger.kicad_pcb from above]

Board: 2 copper layers, 25.0 x 55.0 mm, 18 parts (0 on the bottom side), 12 nets.
