dkay64/HOPEDeCal/(commit log)

2025-01-30 1/29/2025 test push
    [DKLightSensor.kicad_pcb, DKLightSensor.kicad_sch]
2025-02-07 Assigned footprints (floorplanning pending)
    [DKLightSensor.kicad_pcb, DKLightSensor.kicad_sch]
2025-02-07 Continued layout
    [DKLightSensor.kicad_pcb, DKLightSensor.kicad_sch]
2025-02-08 Changed connector placement
    [DKLightSensor.kicad_pcb, DKLightSensor.kicad_sch]
2025-02-08 minimized daisy-chaining (tried to route directly from input power source)
    [DKLightSensor.kicad_pcb]
2025-02-14 deleted trace between diode and resistor
    [DKLightSensor.kicad_pcb]
2025-02-27 Created new proj USBCharger
    [DKUSBCharger.kicad_pcb, DKUSBCharger.kicad_sch]
2025-02-28 added 4 components; created symbol
    [DKUSBCharger.kicad_sch]
2025-02-28 added fuse and schottky diode
    [DKUSBCharger.kicad_sch]
2025-02-28 finished usb charger schematic
    [DKLightSensor.kicad_pcb, DKUSBCharger.kicad_sch]
2025-02-28 Fixing schematic symbols
    [DKUSBCharger.kicad_sch]
2025-02-28 Assigning footprints in schematic
    [DKUSBCharger.kicad_sch]
2025-02-28 finished assigning footprints; updated PCB
    [DKUSBCharger.kicad_pcb, DKUSBCharger.kicad_sch]
2025-03-01 continuing footprint assignmnets
    [DKUSBCharger.kicad_sch]
2025-03-05 Continuing annotations
    [DKUSBCharger.kicad_sch]
2025-03-06 Created dedicated Footprints and Symbols folders
2025-03-06 Finished assigning footprints
2025-03-06 Fixed footprints
    [DKUSBCharger.kicad_sch]
2025-03-06 Fixed footprints; started PCB floorplanning
    [DKUSBCharger.kicad_pcb]
2025-03-06 Finished PCB
    [DKUSBCharger.kicad_pcb]
2025-03-06 Fixing DRC errors
    [DKUSBCharger.kicad_pcb]
2025-03-09 Post check-off edits
    [DKUSBCharger.kicad_pcb]
2025-05-08 added helical files
    [ESP32_S2_SOLO_N4 Kicad Reference Design-B_Cu.gbl, ESP32_S2_SOLO_N4 Kicad Reference Design-B_Mask.gbs, ESP32_S2_SOLO_N4 Kicad Reference Design-B_Paste.gbp, ESP32_S2_SOLO_N4 Kicad Reference Design-B_Silkscreen.gbo, ESP32_S2_SOLO_N4 Kicad Reference Design-Edge_Cuts.gm1, ESP32_S2_SOLO_N4 Kicad Reference Design-F_Cu.gtl, ESP32_S2_SOLO_N4 Kicad Reference Design-F_Mask.gts, ESP32_S2_SOLO_N4 Kicad Refere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]
